philibertc/micronova_controller_pcb/(notices)

Notices in the files:
EDA/PCB/PCB.kicad_pcb:
License: CC-BY-NC-ND
